PetrOdst/mini_Cnc_Jog/PCB/README.MD

# PCB

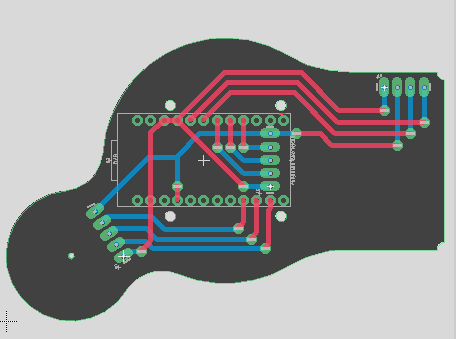
[picture p2: img/Mini_CNC_Jog_PCB.png]
Mini_CNC_Jog_PCB
