PetrOdst/mini_Cnc_Jog/img/Mini_CNC_Jog_FirstTry2.jpg

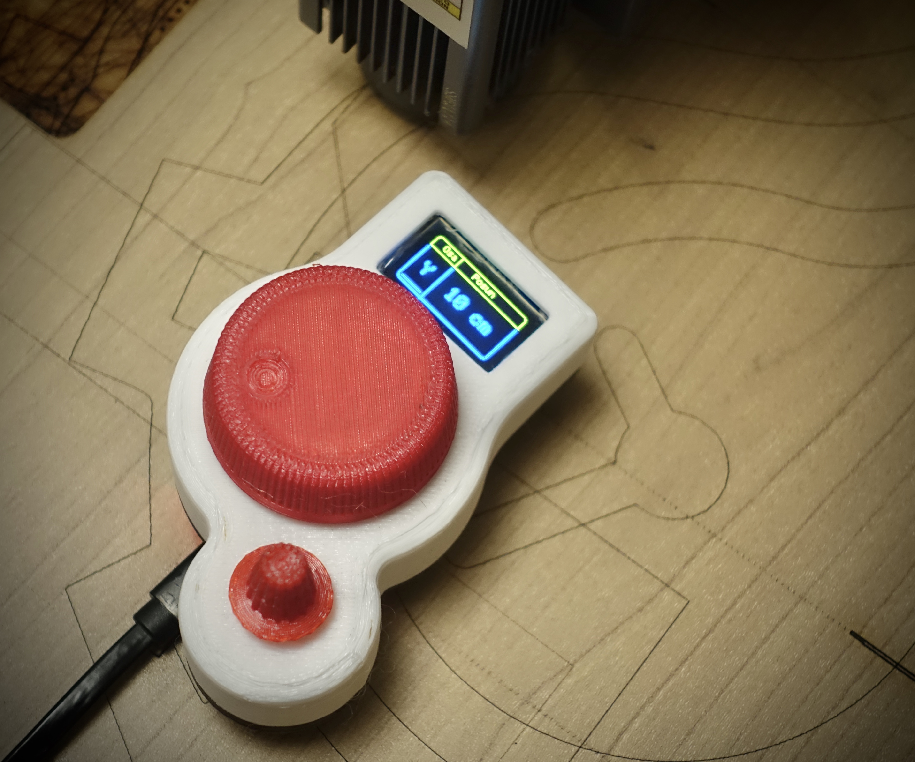
img/Mini_CNC_Jog_FirstTry2.jpg
