PetrOdst/mini_Cnc_Jog/img/Mini_CNC_Jog_FirstTry3.jpg

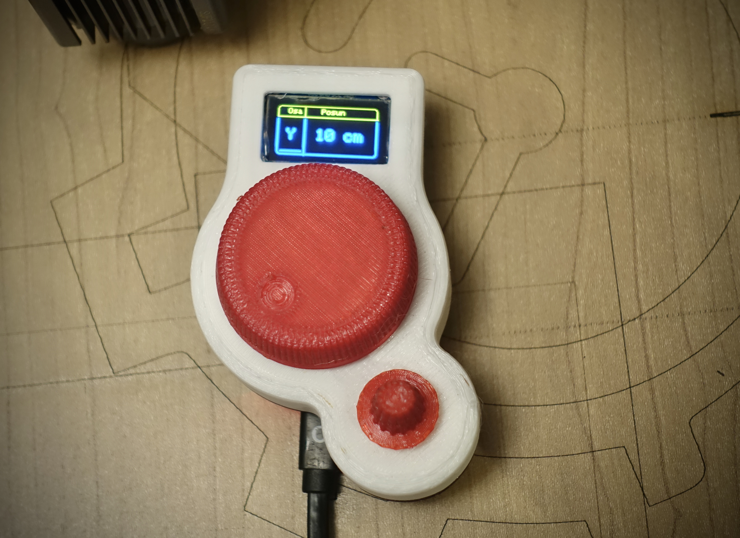
img/Mini_CNC_Jog_FirstTry3.jpg
