PetrOdst/mini_Cnc_Jog/img/Mini_CNC_Jog_Model_ChamferTop2.png

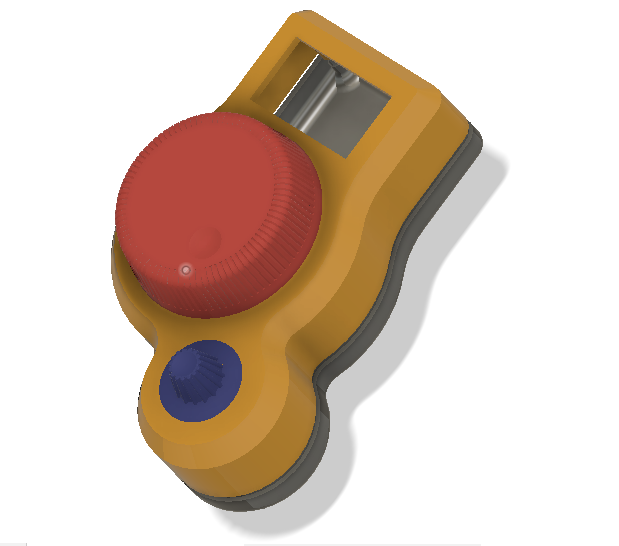
img/Mini_CNC_Jog_Model_ChamferTop2.png
