PetrOdst/mini_Cnc_Jog/img/Mini_CNC_Jog_Model_ChamferTop5.png

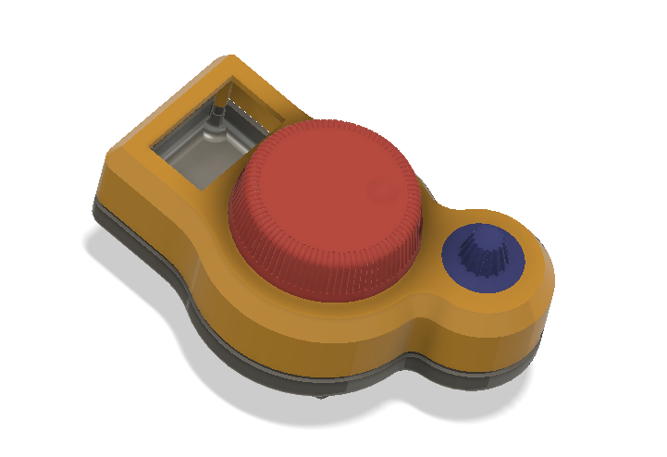
img/Mini_CNC_Jog_Model_ChamferTop5.png
