PetrOdst/mini_Cnc_Jog/img/Mini_CNC_Jog_Model_FilletTop1.png

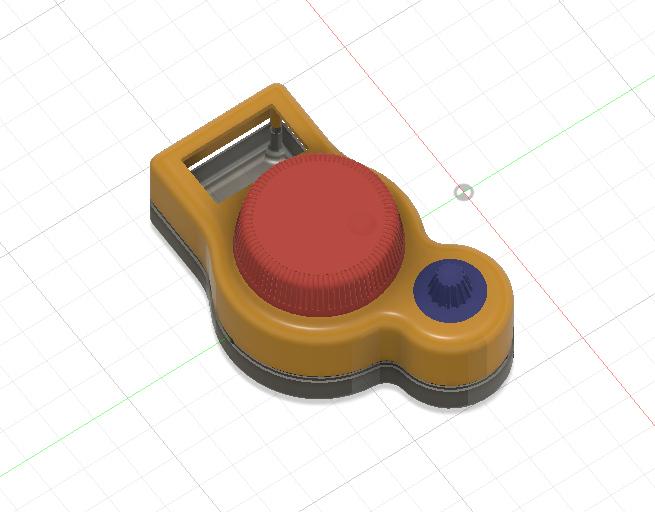
img/Mini_CNC_Jog_Model_FilletTop1.png
