PetrOdst/mini_Cnc_Jog/img/Mini_CNC_Jog_PCB_Creating.png

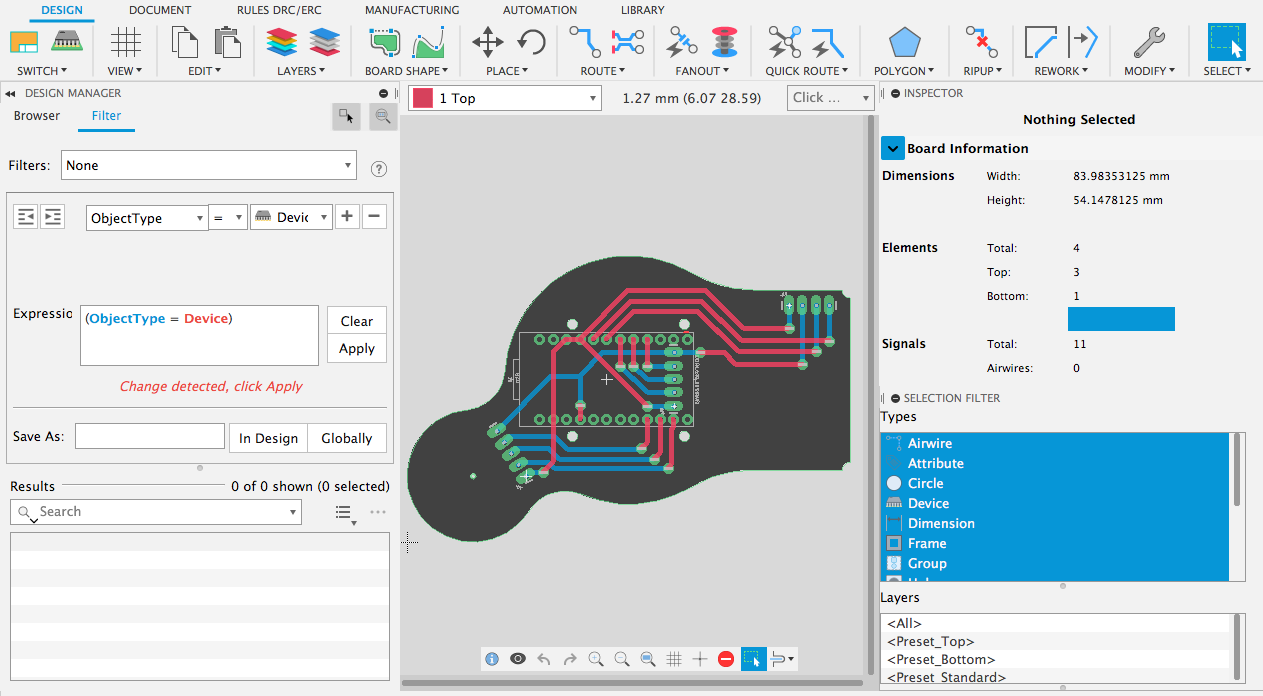
img/Mini_CNC_Jog_PCB_Creating.png
