PetrOdst/mini_Cnc_Jog/PCB/footprints/cncjogzzz1.png

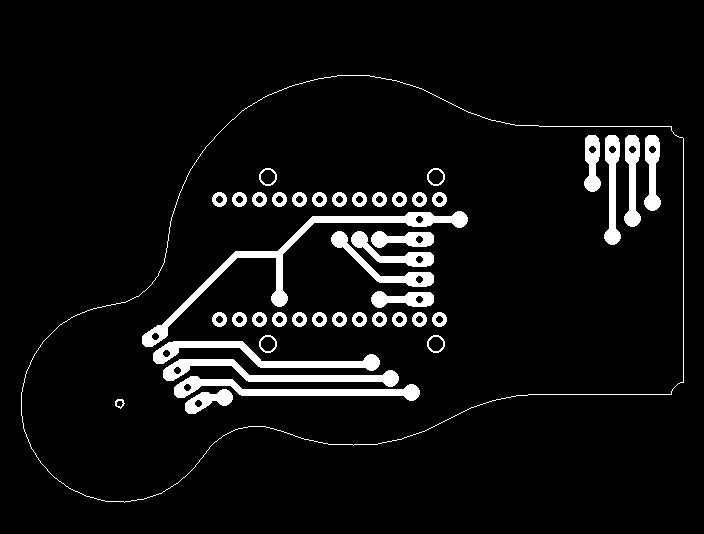
PCB/footprints/cncjogzzz1.png
