PetrOdst/mini_Cnc_Jog/PCB/footprints/cncjogzzz2.png

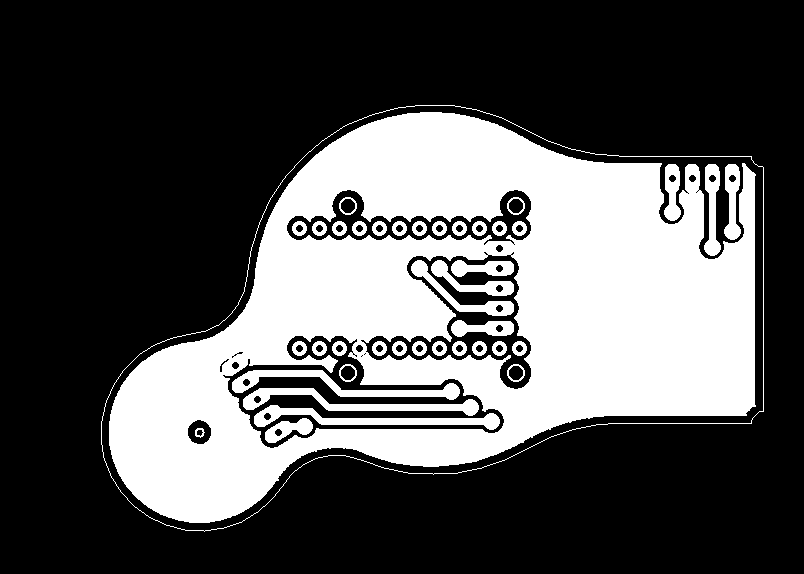
PCB/footprints/cncjogzzz2.png
