PetrOdst/mini_Cnc_Jog/3Dmodels/MiniCNCJog_Knob2.stl

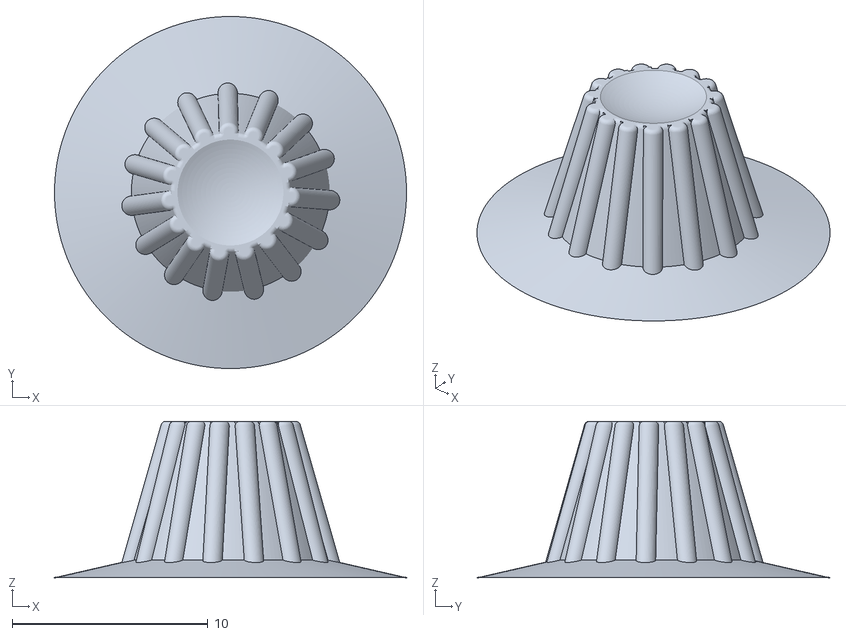
[picture p15: CAD file, 2022-09-27]
3Dmodels/MiniCNCJog_Knob2.stl
18.0 x 18.0 x 8.00
