PetrOdst/mini_Cnc_Jog/PCB/footprints/cncjog_v2.dxf

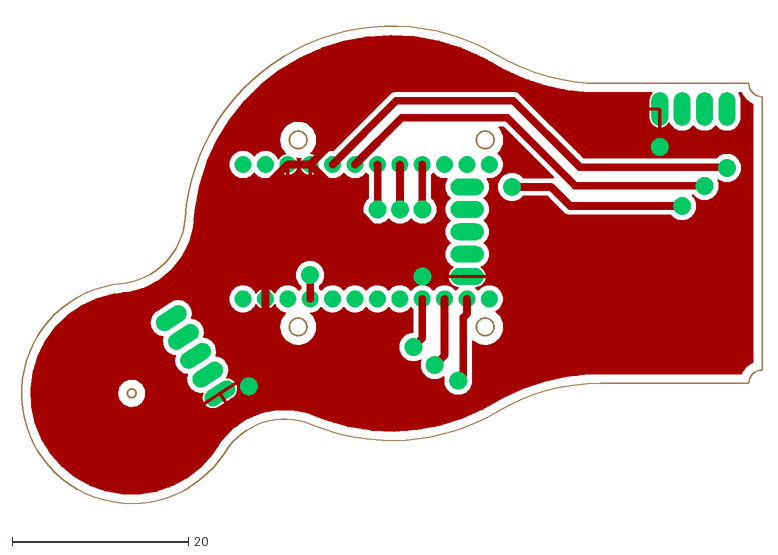
[picture p16: CAD file, 2022-09-27]
PCB/footprints/cncjog_v2.dxf
84.6 x 56.5
