PetrOdst/mini_Cnc_Jog/3Dmodels/MiniCNCJog_Back.stl

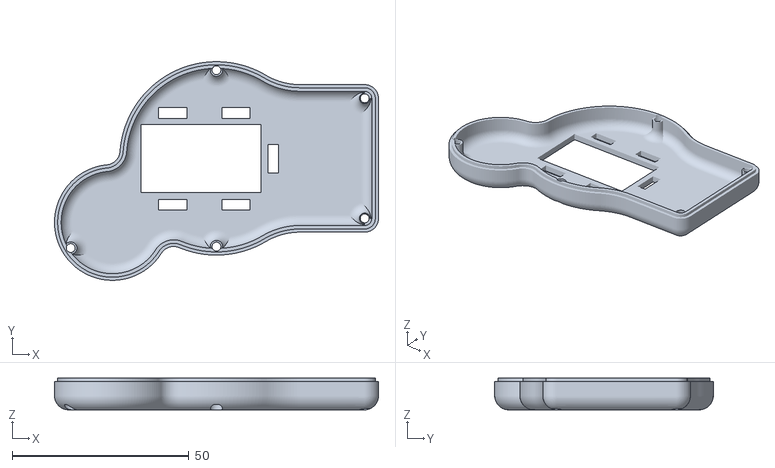
[picture p17: CAD file, 2022-09-27]
3Dmodels/MiniCNCJog_Back.stl
91.8 x 61.9 x 9.00
