PetrOdst/mini_Cnc_Jog/PCB/footprints/jog-Schematic.dxf

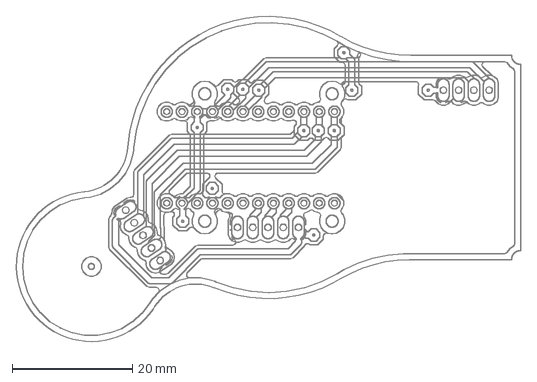
[picture p18: CAD file, 2022-09-27]
PCB/footprints/jog-Schematic.dxf
84.0 x 54.1 mm
