PetrOdst/mini_Cnc_Jog/3Dmodels/MiniCNCJog_HangerMount.stl

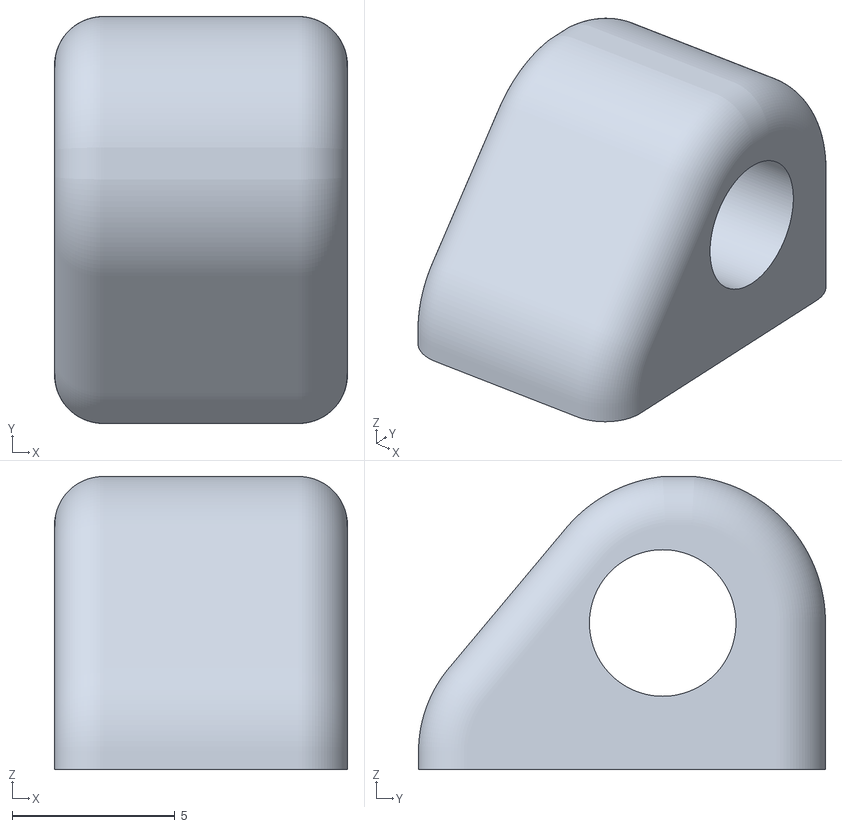
[picture p19: CAD file, 2022-09-27]
3Dmodels/MiniCNCJog_HangerMount.stl
9.00 x 12.5 x 9.00
