PetrOdst/mini_Cnc_Jog/PCB/footprints/jog-Schematic2.dxf

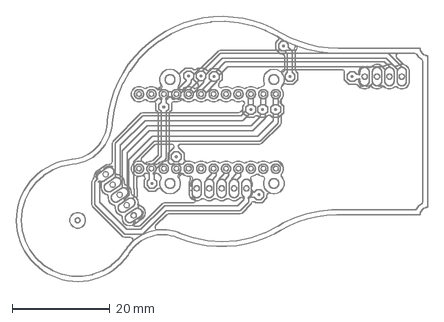
[picture p20: CAD file, 2022-09-27]
PCB/footprints/jog-Schematic2.dxf
84.0 x 54.1 mm
