PetrOdst/mini_Cnc_Jog/3Dmodels/MiniCNCJog_Body.stl

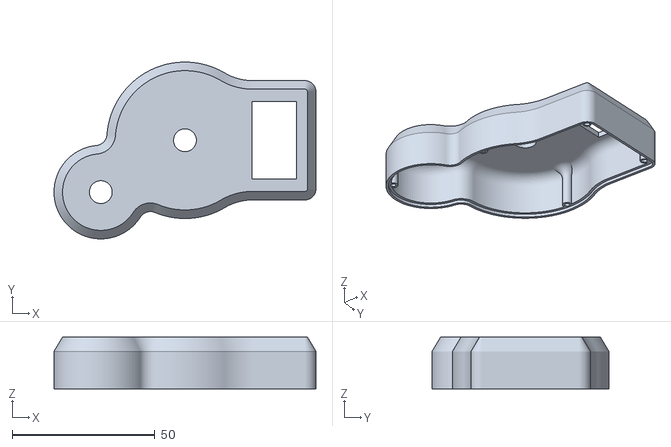
[picture p21: CAD file, 2022-09-27]
3Dmodels/MiniCNCJog_Body.stl
91.8 x 61.9 x 18.2
