PetrOdst/mini_Cnc_Jog/3Dmodels/MiniCNCJog_ESPCover.stl

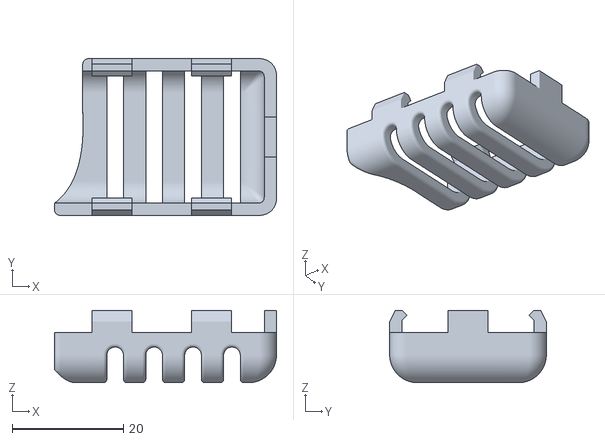
[picture p22: CAD file, 2022-09-27]
3Dmodels/MiniCNCJog_ESPCover.stl
39.9 x 28.2 x 13.0
