PetrOdst/mini_Cnc_Jog/3Dmodels/MiniCNCJog_Knob1.stl

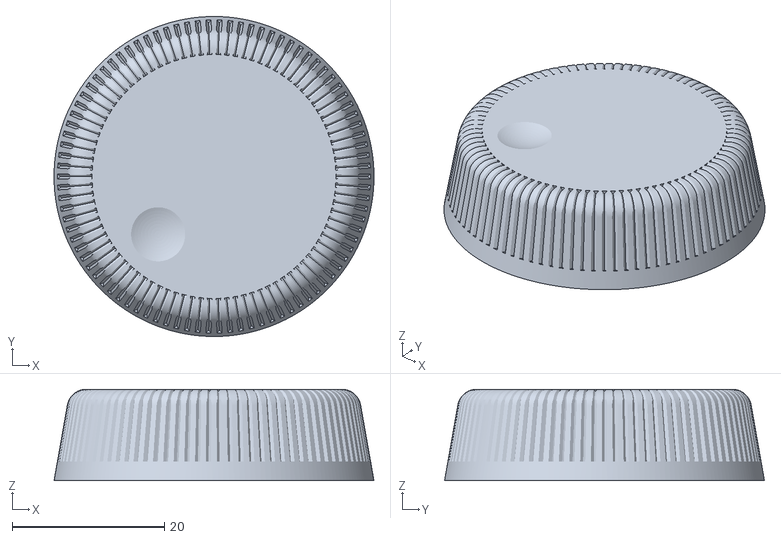
[picture p23: CAD file, 2022-09-27]
3Dmodels/MiniCNCJog_Knob1.stl
42.0 x 42.0 x 12.0
