PetrOdst/mini_Cnc_Jog/PCB/footprints/cncjog_v2.pdf

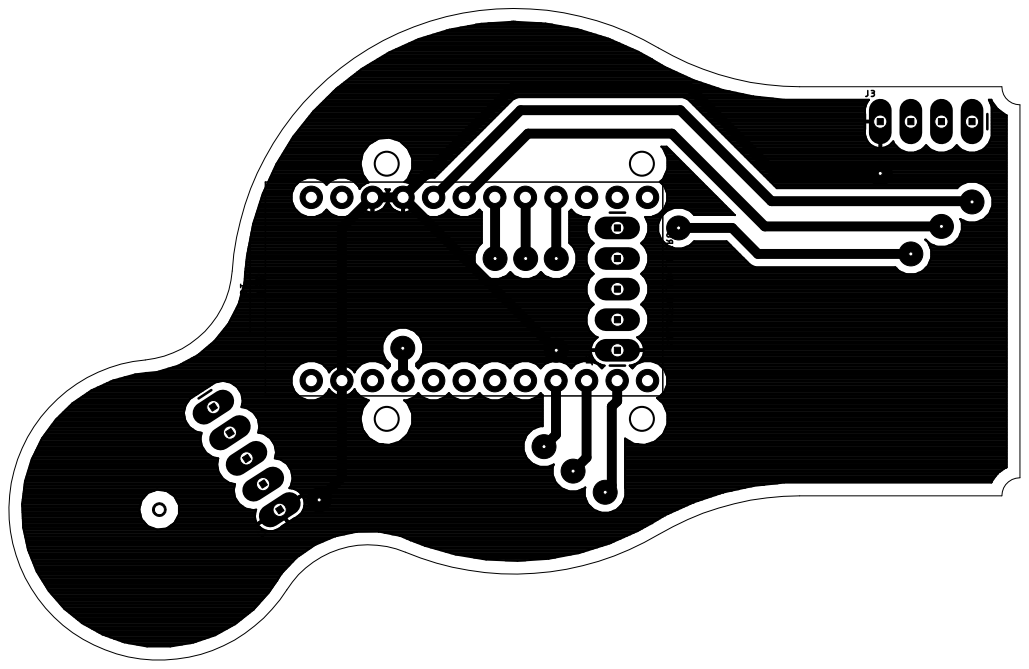
[picture p24: page 1]
